micksuffolk/Microchip_Weather_Station/README.md

# Weather Station

Weather Station (Temperature, Humidity, and Pressure) using Microchip PIC16F887 & LCD display. Application Developed using Microchip MPLABX IDE and XC8 compiler.

## Board Information

1. Board layer: 2
2. Length: 100mm [x]
3. Width: 100mm [y]
4. Base Material: FR4 Tg 130 (Default option)
5. Thickness: 1.6mm
6. Copper Weight: 1.0oz
7. Solder Mask: both top & bottom
8. Solder Mask Color: Green
9. Silk screen: Only top
10. Surface: HASL (lead free)
11. UL Marking: No
