micksuffolk/Microchip_Weather_Station/Gerber/Mechanical 1.TXT

G04 PROTEUS RS274X GERBER FILE*
%FSLAX24Y24*%
%MOIN*%
%ADD19C,0.0080*%
G54D19*
X-19733Y-19685D02*
X+19685Y-19685D01*
X+19685Y+19685D01*
X-19733Y+19685D01*
X-19733Y-19685D01*
M00*
