micksuffolk/Microchip_Weather_Station/Bottom Silk.png

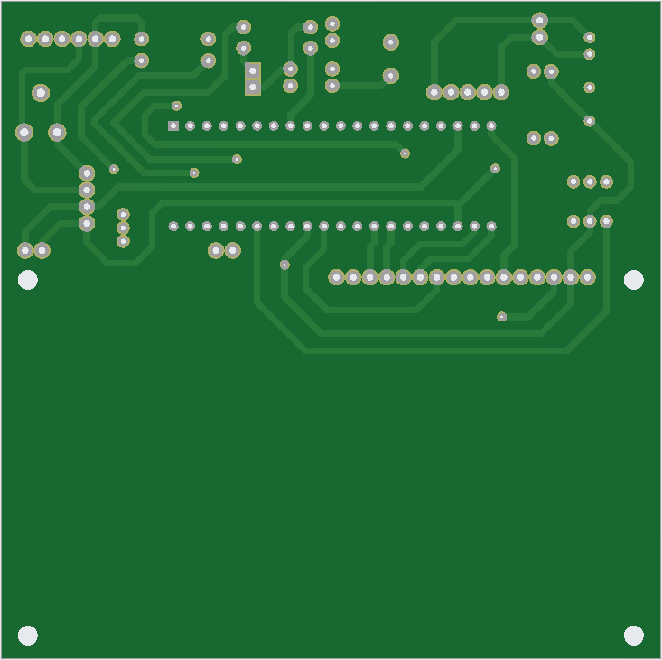
Bottom Silk.png
