micksuffolk/Microchip_Weather_Station/Top Silk.png

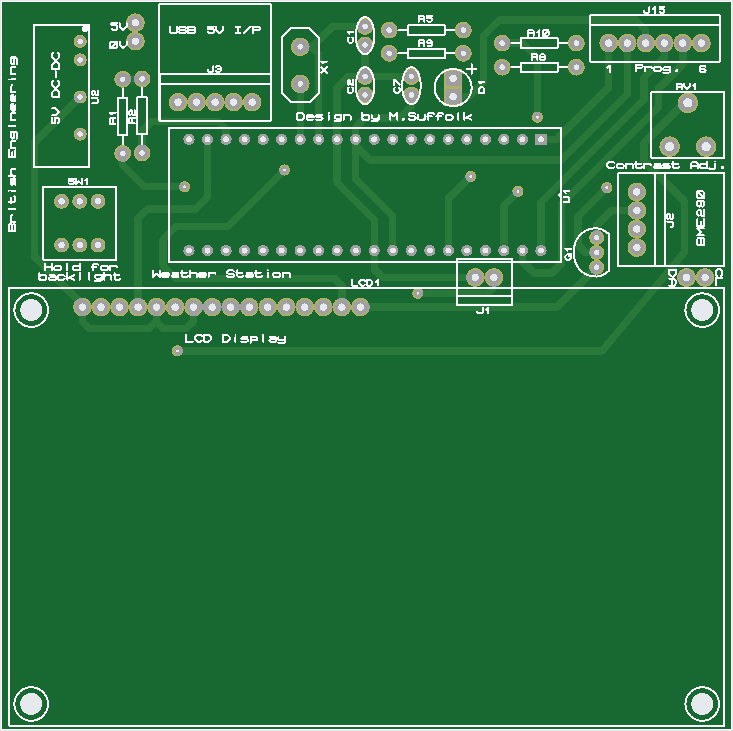
Top Silk.png
