micksuffolk/Microchip_Weather_Station/Schematic.PDF

U1

J15

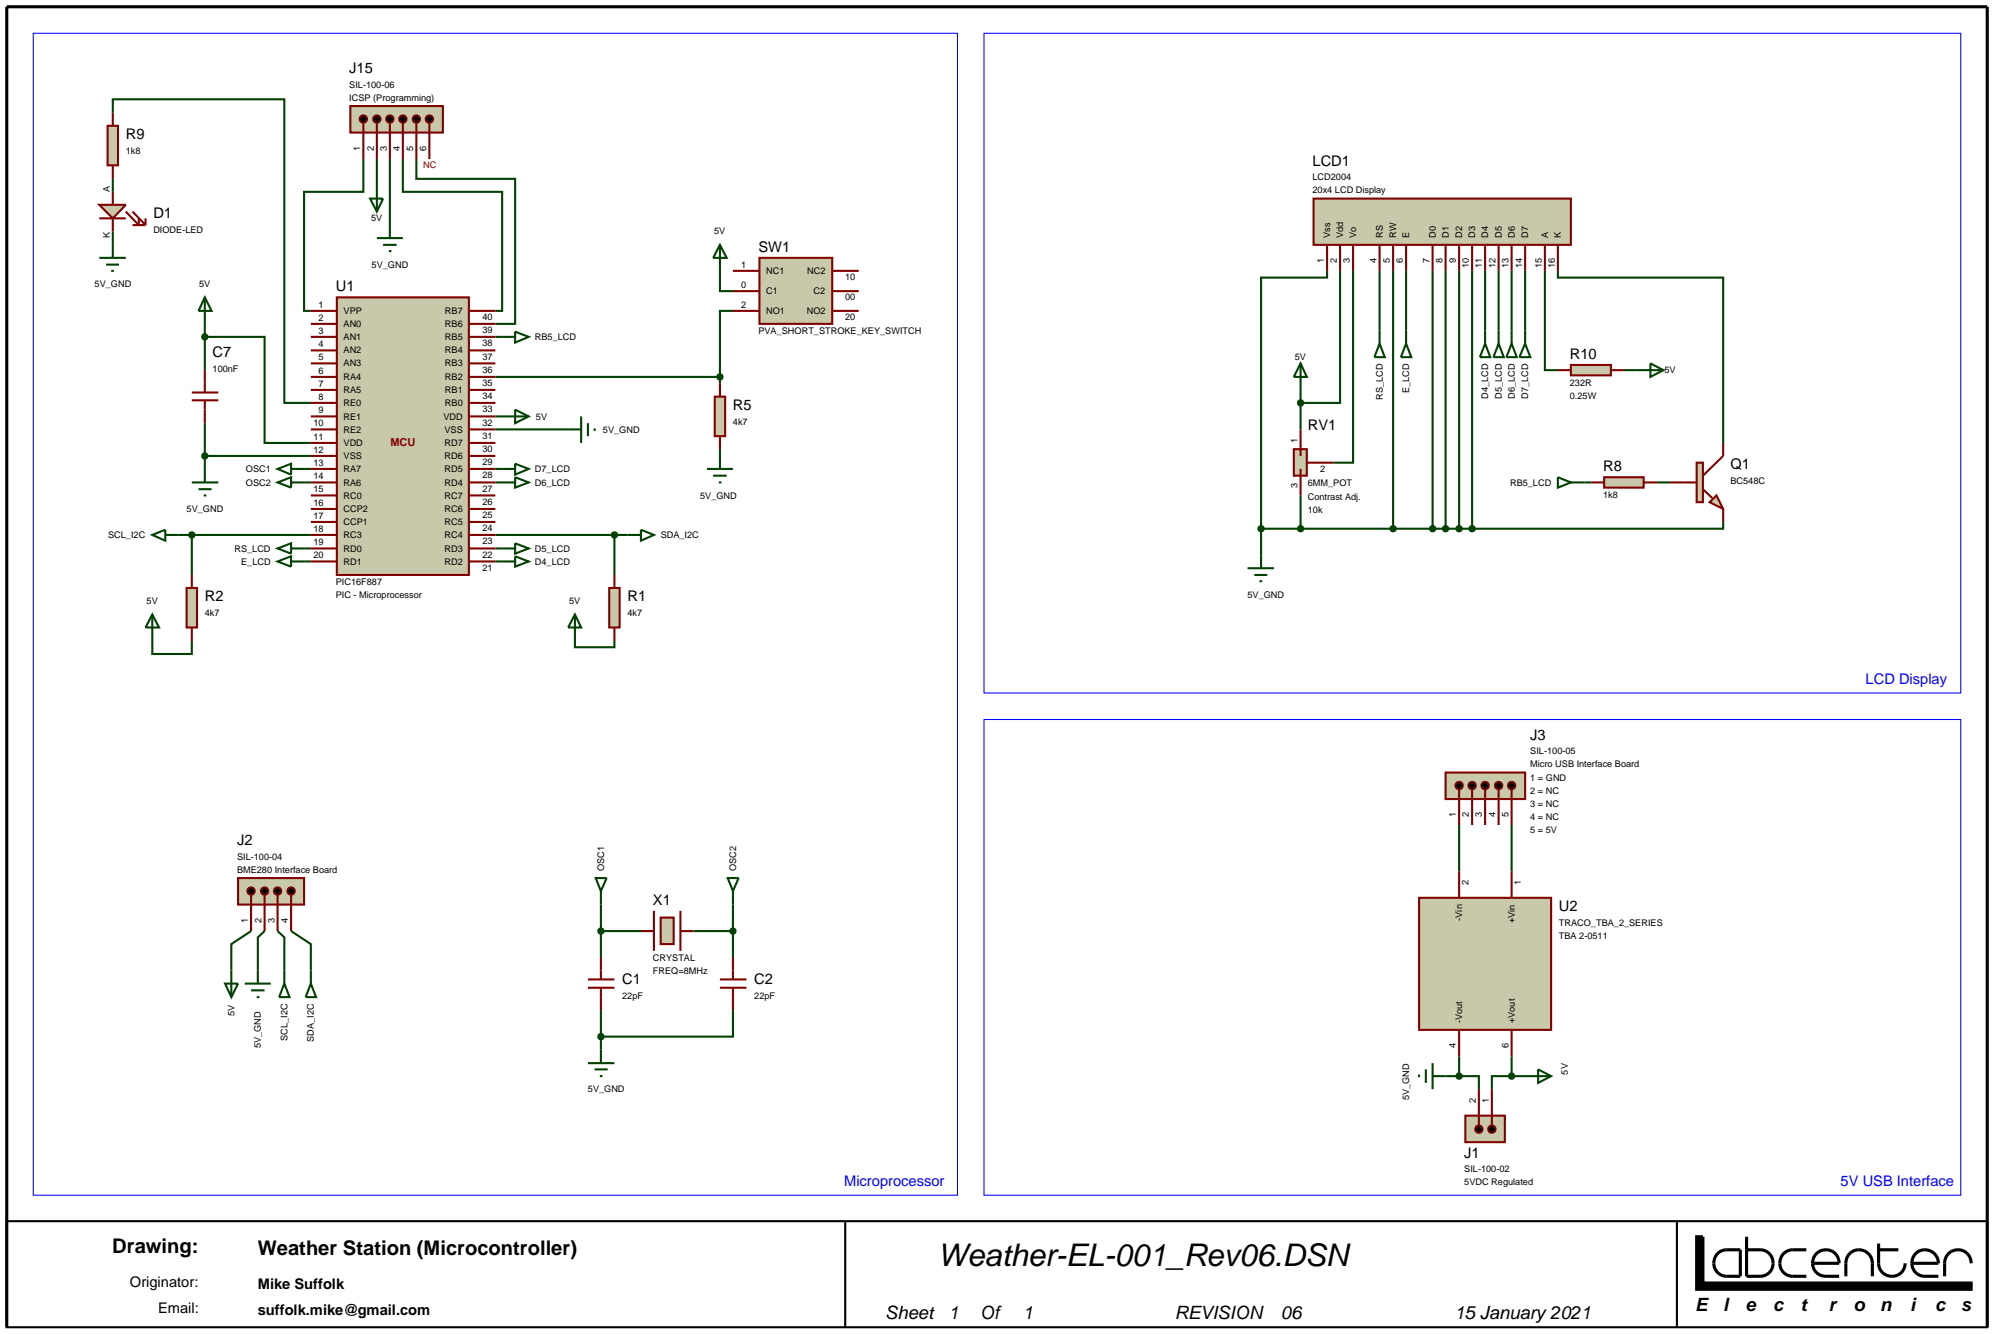
[picture p3: page 1]
