micksuffolk/Microchip_Weather_Station/Board layout.pdf

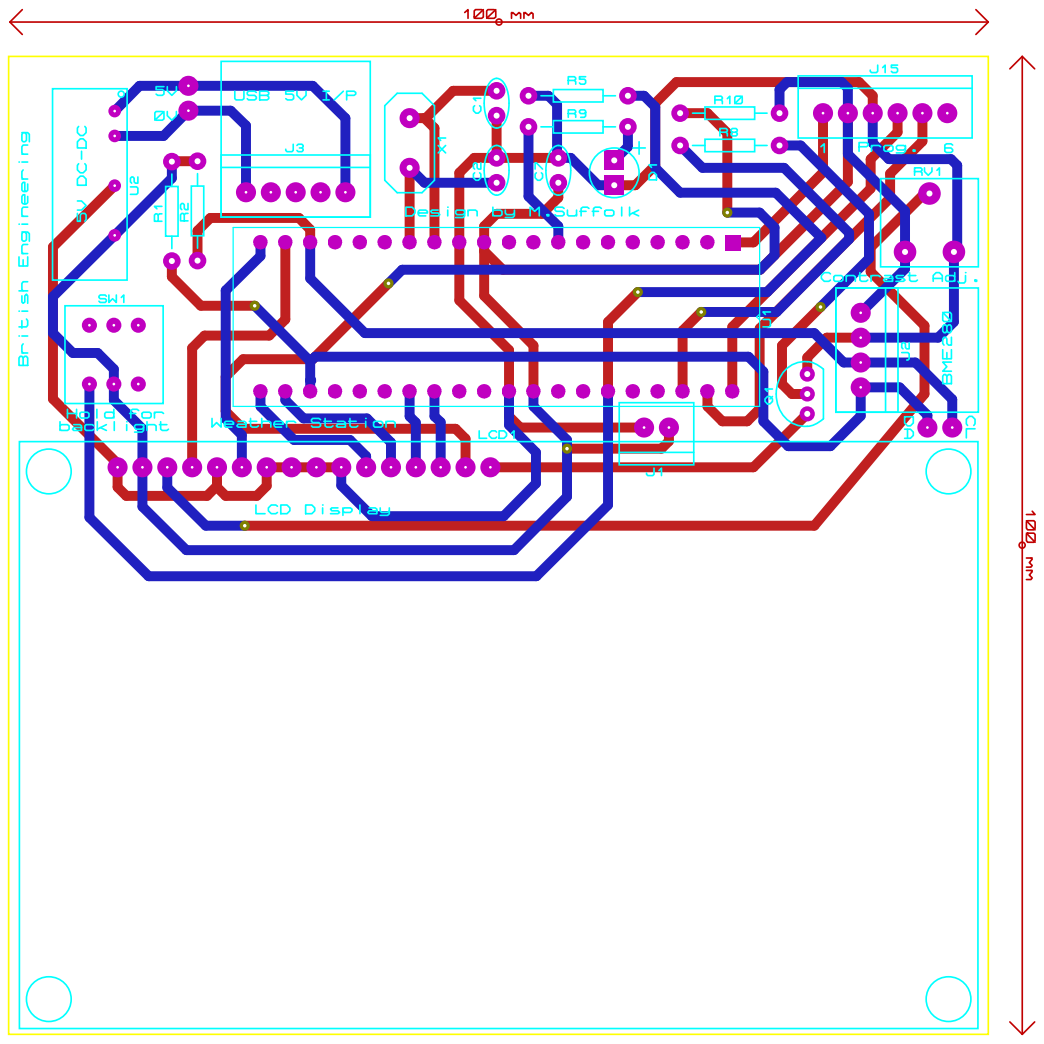
[picture p4: page 1]
