micksuffolk/Microchip_Weather_Station/(list of files, drawings)

Other design files:
Board layout.LYT
Schematic.DSN
