micksuffolk/Microchip_Weather_Station/Gerber/Bottom Solder Resist.TXT

G04 PROTEUS RS274X GERBER FILE*
%FSLAX24Y24*%
%MOIN*%
%ADD14C,0.0600*%
%ADD21C,0.1000*%
%ADD13R,0.0600X0.0600*%
%ADD12C,0.0800*%
%ADD17C,0.0900*%
%ADD22R,0.1000X0.1000*%
%ADD23C,0.1100*%
%ADD15C,0.0700*%
%ADD19C,0.0080*%
G54D14*
X-9842Y+9645D03*
X+12950Y+9600D03*
X+8150Y+9400D03*
X+5600Y+10200D03*
X+9200Y+13400D03*
X-4450Y+10550D03*
X-10236Y+787D03*
X+2750Y+3900D03*
G54D21*
X-15354Y+3149D03*
X-14354Y+3149D03*
X-13354Y+3149D03*
X-12354Y+3149D03*
X-11354Y+3149D03*
X-10354Y+3149D03*
X-9354Y+3149D03*
X-8354Y+3149D03*
X-7354Y+3149D03*
X-6354Y+3149D03*
X-5354Y+3149D03*
X-4354Y+3149D03*
X-3354Y+3149D03*
X-2354Y+3149D03*
X-1354Y+3149D03*
X-354Y+3149D03*
G54D13*
X+9393Y+12204D03*
G54D14*
X+8393Y+12204D03*
X+7393Y+12204D03*
X+6393Y+12204D03*
X+5393Y+12204D03*
X+4393Y+12204D03*
X+3393Y+12204D03*
X+2393Y+12204D03*
X+1393Y+12204D03*
X+393Y+12204D03*
X-606Y+12204D03*
X-1606Y+12204D03*
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
