micksuffolk/Microchip_Weather_Station/LCD.h

/*
 * Header file to use LCD with PIC16F887 or similar
 * Author: Mike Suffolk
 */



void Lcd_SetBit(char data_bit) //Based on the Hex value Set the Bits of the Data Lines
{
	if(data_bit& 1) 
		LCD_D4 = 1;
	else
		LCD_D4 = 0;

	if(data_bit& 2)
		LCD_D5 = 1;
	else
		LCD_D5 = 0;

	if(data_bit& 4)
		LCD_D6 = 1;
	else
		LCD_D6 = 0;

	if(data_bit& 8) 
		LCD_D7 = 1;
	else
		LCD_D7 = 0;
}

void Lcd_Cmd(char a)
{
	LCD_RS = 0;           
	Lcd_SetBit(a); //Incoming Hex value
	LCD_EN  = 1;         
        __delay_ms(4);
        LCD_EN  = 0;         
}

Lcd_Clear()
{
	Lcd_Cmd(0); //Clear the LCD
	Lcd_Cmd(1); //Move the cursor to first position
}

void Lcd_Set_Cursor(char a, char b)
{
	char temp,z,y;
	if(a== 1)
	{
	  temp = 0x80 + b - 1; //80H is used to move the cursor
		z = temp>>4; //Lower 8-bits
		y = temp & 0x0F; //Upper 8-bits
		Lcd_Cmd(z); //Set Row
		Lcd_Cmd(y); //Set Column
	}
	else if(a== 2)
	{
		temp = 0xC0 + b - 1;
		z = temp>>4; //Lower 8-bits
		y = temp & 0x0F; //Upper 8-bits
		Lcd_Cmd(z); //Set Row
		Lcd_Cmd(y); //Set Column
	}
	else if(a== 3)
	{
		temp = 0x94 + b - 1;
		z = temp>>4; //Lower 8-bits
		y = temp & 0x0F; //Upper 8-bits
		Lcd_Cmd(z); //Set Row
		Lcd_Cmd(y); //Set Column
	}
	else if(a== 4)
	{
		temp = 0xD4 + b - 1;
		z = temp>>4; //Lower 8-bits
		y = temp & 0x0F; //Upper 8-bits
		Lcd_Cmd(z); //Set Row
		Lcd_Cmd(y); //Set Column
	}
}

void Lcd_Start()
{
  Lcd_SetBit(0x00);
  for(int i=1065244; i<=0; i--)  NOP();  
  Lcd_Cmd(0x03);
	__delay_ms(5);
  Lcd_Cmd(0x03);
	__delay_ms(11);
  Lcd_Cmd(0x03); 
  Lcd_Cmd(0x02);
  Lcd_Cmd(0x02);
  Lcd_Cmd(0x08);
  Lcd_Cmd(0x00);
  Lcd_Cmd(0x0C);
  Lcd_Cmd(0x00);
  Lcd_Cmd(0x06);
}

void Lcd_Print_Char(char data)  //Send 8-bits through 4-bit mode
{
   char Lower_Nibble,Upper_Nibble;
   Lower_Nibble = data&0x0F;
   Upper_Nibble = data&0xF0;
   LCD_RS = 1;             // => RS = 1
   Lcd_SetBit(Upper_Nibble>>4);             //Send upper half by shifting by 4
   LCD_EN = 1;
   for(int i=2130483; i<=0; i--)  NOP(); 
   LCD_EN = 0;
   Lcd_SetBit(Lower_Nibble); //Send Lower half
   LCD_EN = 1;
   for(int i=2130483; i<=0; i--)  NOP();
   LCD_EN = 0;
}

void Lcd_Print_String(char *a)
{
	int i;
	for(i=0;a[i]!='\0';i++)
	   Lcd_Print_Char(a[i]);  //Split the string using pointers and call the Char function 
}
